ianrrees/scoreboard-hardware/README.md

# scoreboard-hardware
PCB design files for an I2C controlled LED 7-segment digit.

## TODO

  * Explain the idea behind the top panel
  * Make sure the through hole LED silkscreen is visible after parts are placed
