ianrrees/scoreboard-hardware/scoreboard.pdf

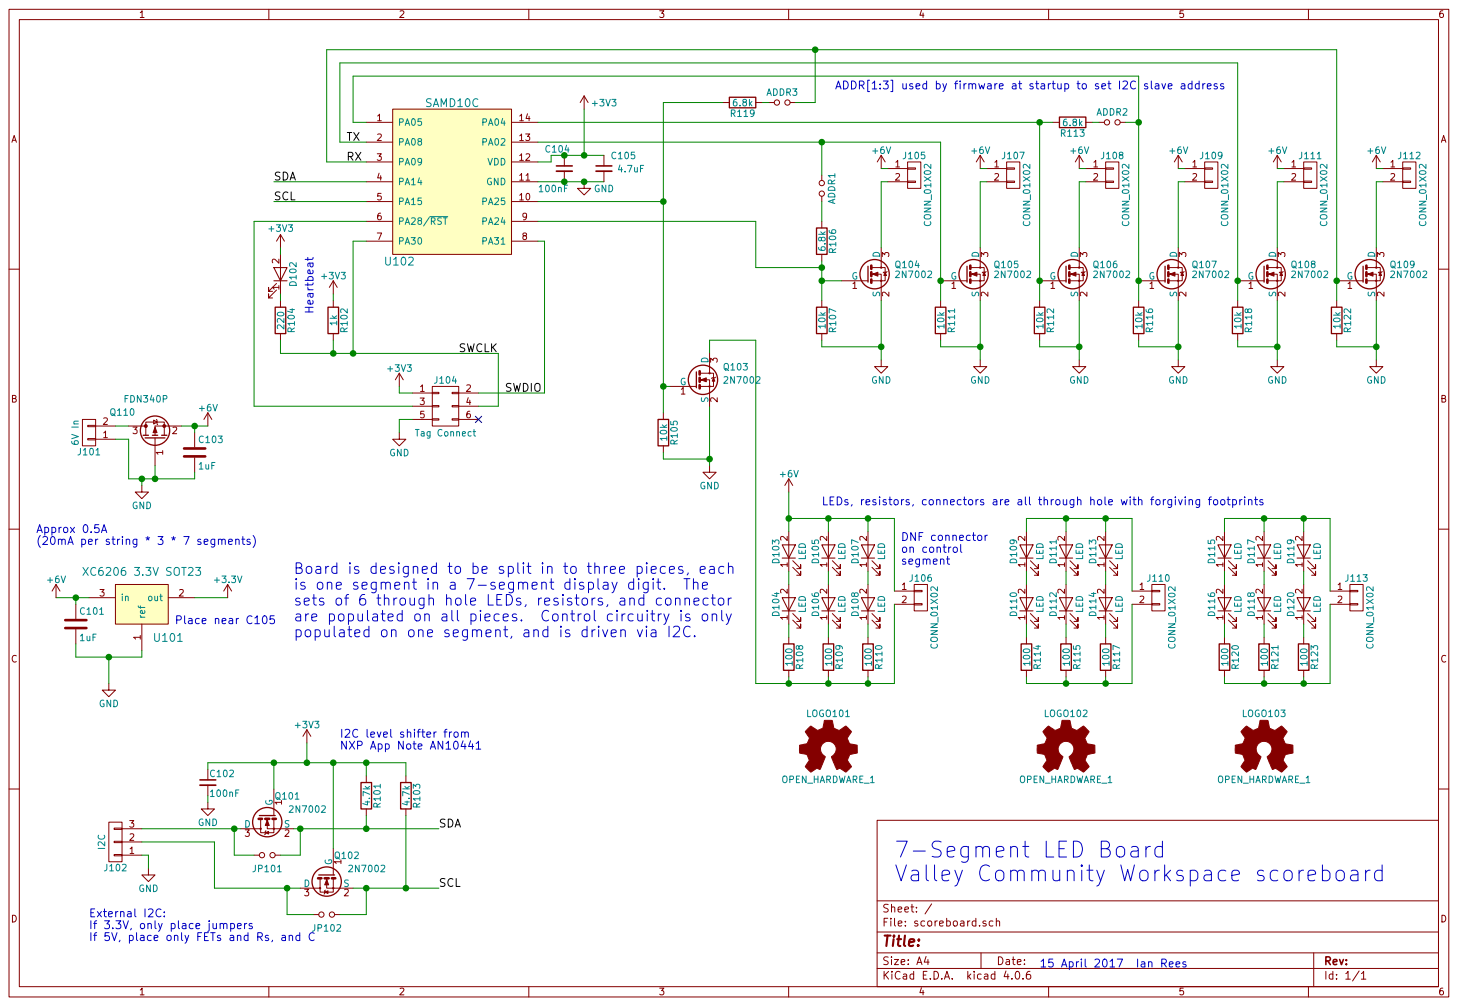
[picture p1: page 1]

sets of 6 through hole LEDs, resistors, and connector
are populated on all pieces. Control circuitry is only

Valley Community Workspace scoreboard

Id: 1/1 Title: File: scoreboard.sch Sheet: /

If 3.3V, only place jumpers
If 5V, place only FETs and Rs, and C
