ianrrees/scoreboard-hardware/scoreboard.kicad_pcb

## KiCad design scoreboard.kicad_pcb (2017-05-03)

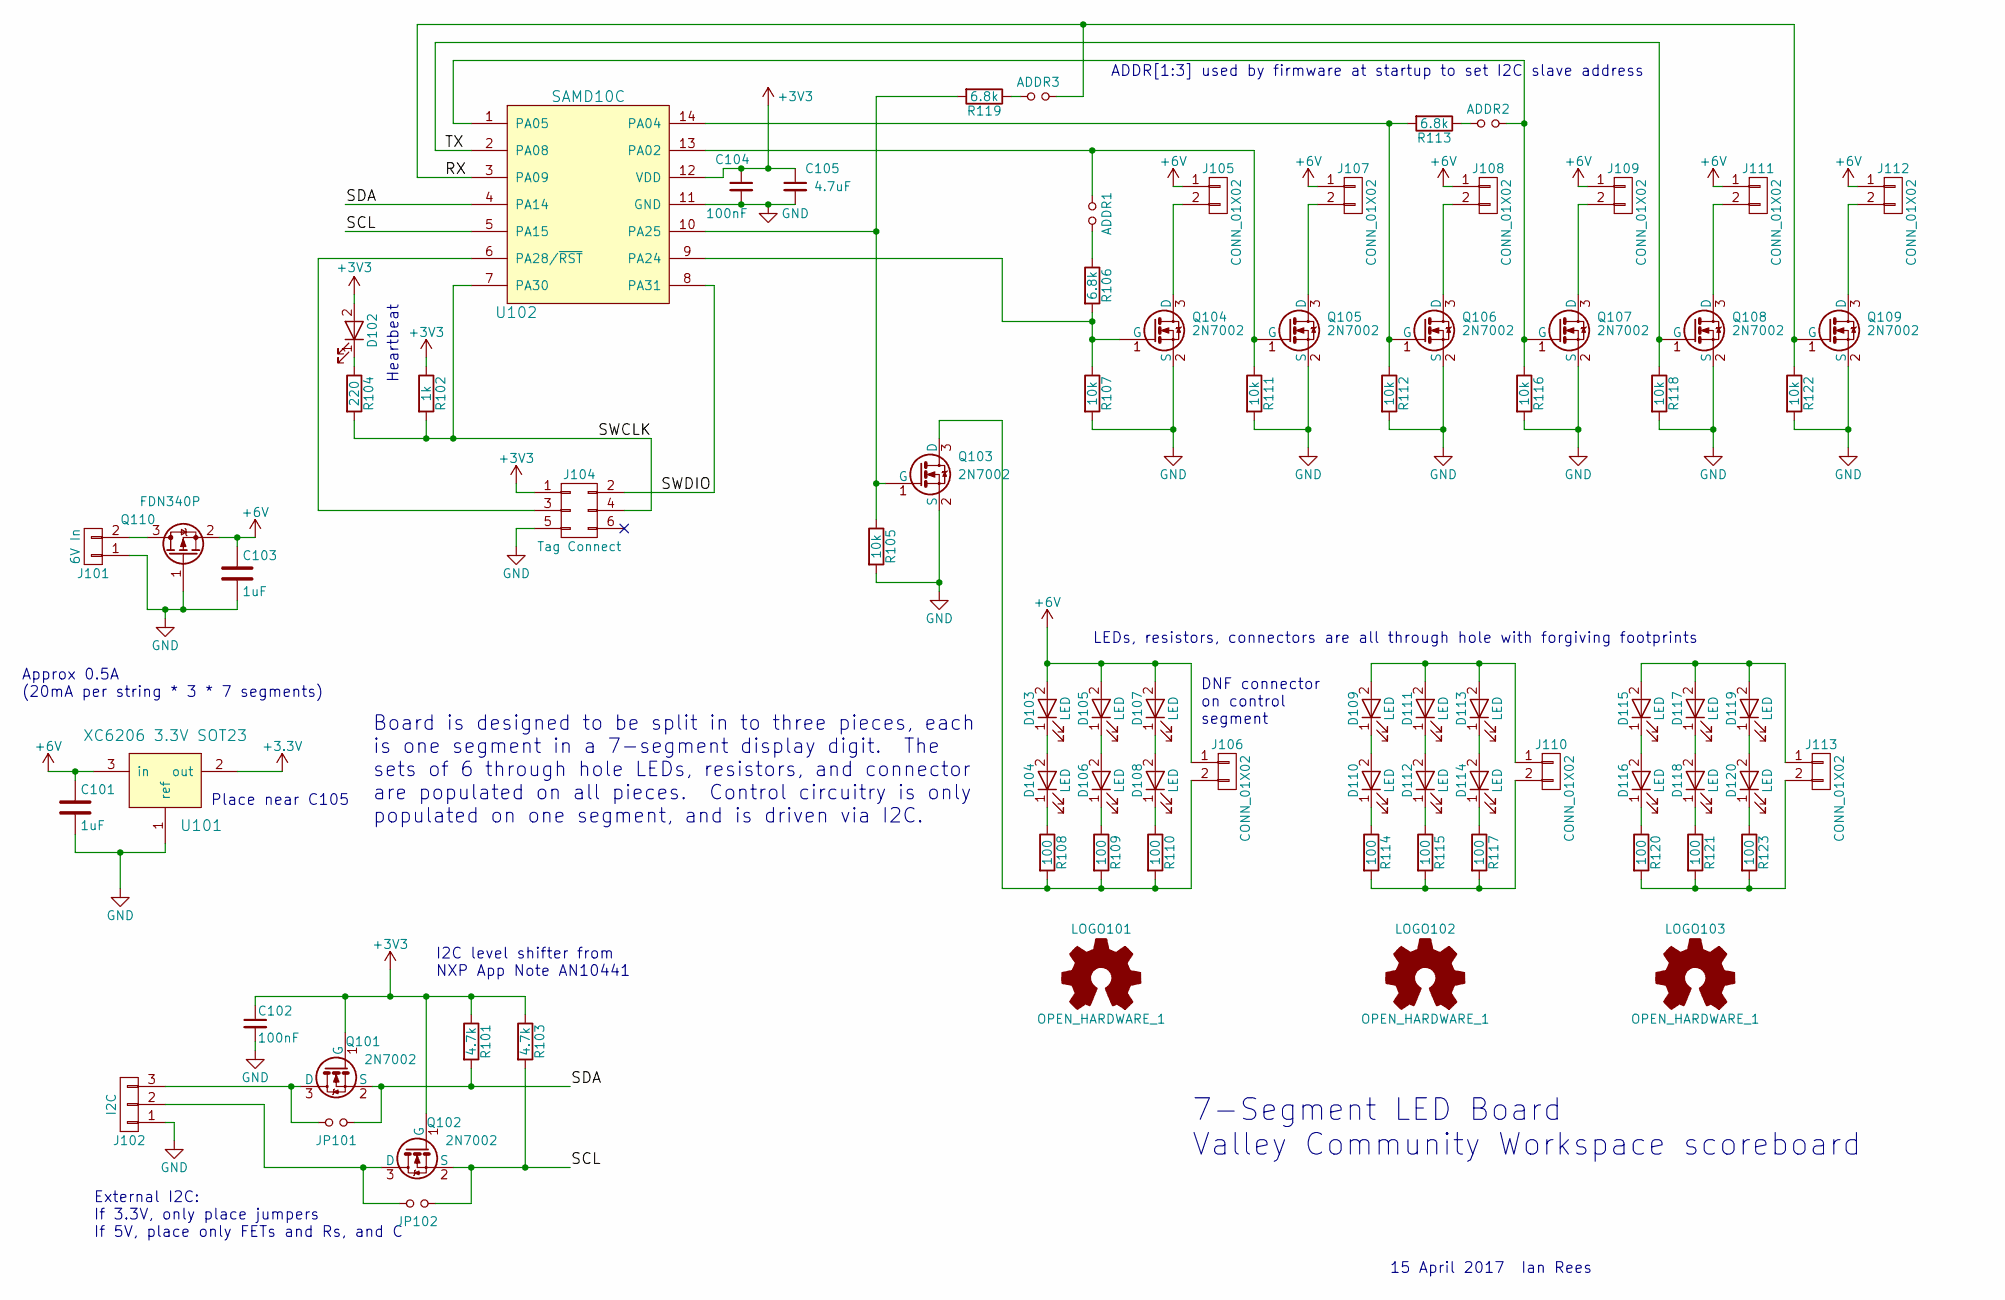
[picture p2: schematic scoreboard.sch]

Parts:
ADDR1, ADDR2, ADDR3: Jumper_NO_Small; solder_jumper
C101, C103: 1uF; C_0603_HandSoldering
C102, C104: 100nF; C_0603_HandSoldering
C105: 4.7uF; C_0603_HandSoldering
D102: LED; led_0603_HandSoldering
D103, D104, D105, D106, D107, D108, D109, D110, D111, D112, D113, D114, D115, D116, D117, D118, D119, D120: LED; LED_D5.0mm
J101: 6V In; AK300-min
J102: I2C; Molex_MicroLatch-53253-0370_03x2.00mm_Straight
J104: Tag Connect; Tag-Connect_TC2030-IDC-FP
J105, J106, J107, J108, J109, J110, J111, J112, J113: CONN_01X02; AK300-min
JP101, JP102: Jumper_NO_Small; R_0603_HandSoldering
LOGO101, LOGO102, LOGO103: OPEN_HARDWARE_1; Symbol_OSHW-Logo_CopperTop
Q101, Q102, Q103, Q104, Q105, Q106, Q107, Q108, Q109: 2N7002; SOT-23
Q110: FDN340P; SOT-23_Handsoldering
R101, R103: 4.7k; R_0603_HandSoldering
R102: 1k; R_0603_HandSoldering
R104: 220; R_0603_HandSoldering
R105, R107, R111, R112, R116, R118, R122: 10k; R_0603_HandSoldering
R106, R113, R119: 6.8k; R_0603_HandSoldering
R108, R109, R110, R114, R115, R117, R120, R121, R123: 100; R_Axial_DIN0411_L9.9mm_D3.6mm_P15.24mm_Horizontal
U101: XC6206 3.3V SOT23; SOT-23_Handsoldering
U102: SAMD10C; SOIC-14_3.9x8.7mm_Pitch1.27mm

Connections:
+6V: C101.1, C103.1, D103.2 (A), D105.2 (A), D107.2 (A), J105.1, J106.1, J107.1, J108.1, J109.1, J111.1, J112.1, Q110.2 (S), U101.3 (in)
/RX: ADDR3.2, Q109.1 (G), R122.1, U102.3 (PA09)
/SCL: JP102.2, Q102.2 (S), R103.2, U102.5 (PA15)
/SDA: JP101.2, Q101.2 (S), R101.2, U102.4 (PA14)
/SWCLK: J104.4, R102.2, R104.2, U102.7 (PA30)
/SWDIO: J104.2, U102.8 (PA31)
/TX: Q108.1 (G), R118.1, U102.2 (PA08)
GND: C101.2, C102.2, C103.2, C104.2, C105.2, J101.1, J102.1, J104.5, Q103.2 (S), Q104.2 (S), Q105.2 (S), Q106.2 (S), Q107.2 (S), Q108.2 (S), Q109.2 (S), Q110.1 (G), R105.2, R107.2, R111.2, R112.2, R116.2, R118.2, R122.2, U101.1 (ref), U102.11 (GND)
unnamed: ADDR1.1, Q105.1 (G), R111.1, U102.13 (PA02)
unnamed: ADDR1.2, R106.1
unnamed: ADDR2.1, R113.1
unnamed: ADDR2.2, Q107.1 (G), R116.1, U102.1 (PA05)
unnamed: ADDR3.1, R119.1
unnamed: D102.1 (K), R104.1
unnamed: D103.1 (K), D104.2 (A)
unnamed: D104.1 (K), R108.1
unnamed: D105.1 (K), D106.2 (A)
unnamed: D106.1 (K), R109.1
unnamed: D107.1 (K), D108.2 (A)
unnamed: D108.1 (K), R110.1
unnamed: D109.1 (K), D110.2 (A)
unnamed: D109.2 (A), D111.2 (A), D113.2 (A), J110.1
unnamed: D110.1 (K), R114.1
unnamed: D111.1 (K), D112.2 (A)
unnamed: D112.1 (K), R115.1
unnamed: D113.1 (K), D114.2 (A)
unnamed: D114.1 (K), R117.1
unnamed: D115.1 (K), D116.2 (A)
unnamed: D115.2 (A), D117.2 (A), D119.2 (A), J113.1
unnamed: D116.1 (K), R120.1
unnamed: D117.1 (K), D118.2 (A)
unnamed: D118.1 (K), R121.1
unnamed: D119.1 (K), D120.2 (A)
unnamed: D120.1 (K), R123.1
unnamed: J101.2, Q110.3 (D)
unnamed: J102.2, JP102.1, Q102.3 (D)
unnamed: J102.3, JP101.1, Q101.3 (D)
unnamed: J104.3, U102.6 (PA28/~RST)
unnamed: J105.2, Q104.3 (D)
unnamed: J106.2, Q103.3 (D), R108.2, R109.2, R110.2
unnamed: J107.2, Q105.3 (D)
unnamed: J108.2, Q106.3 (D)
unnamed: J109.2, Q107.3 (D)
unnamed: J110.2, R114.2, R115.2, R117.2
unnamed: J111.2, Q108.3 (D)
unnamed: J112.2, Q109.3 (D)
unnamed: J113.2, R120.2, R121.2, R123.2
unnamed: Q103.1 (G), R105.1, R119.2, U102.10 (PA25)
unnamed: Q104.1 (G), R106.2, R107.1, U102.9 (PA24)
unnamed: Q106.1 (G), R112.1, R113.2, U102.14 (PA04)

Notes on the sheet:
External I2C: If 3.3V, only place jumpers If 5V, place only FETs and Rs, and C
I2C level shifter from NXP App Note AN10441
Heartbeat
LEDs, resistors, connectors are all through hole with forgiving footprints
Board is designed to be split in to three pieces, each is one segment in a 7-segment display digit. The sets of 6 through hole LEDs, resistors, and connector are populated on all pieces. Control circuitry is only populated on one segment, and is driven via I2C.
DNF connector on control segment
ADDR[1:3] used by firmware at startup to set I2C slave address
7-Segment LED Board Valley Community Workspace scoreboard
15 April 2017 Ian Rees
Place near C105
Approx 0.5A (20mA per string * 3 * 7 segments)

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
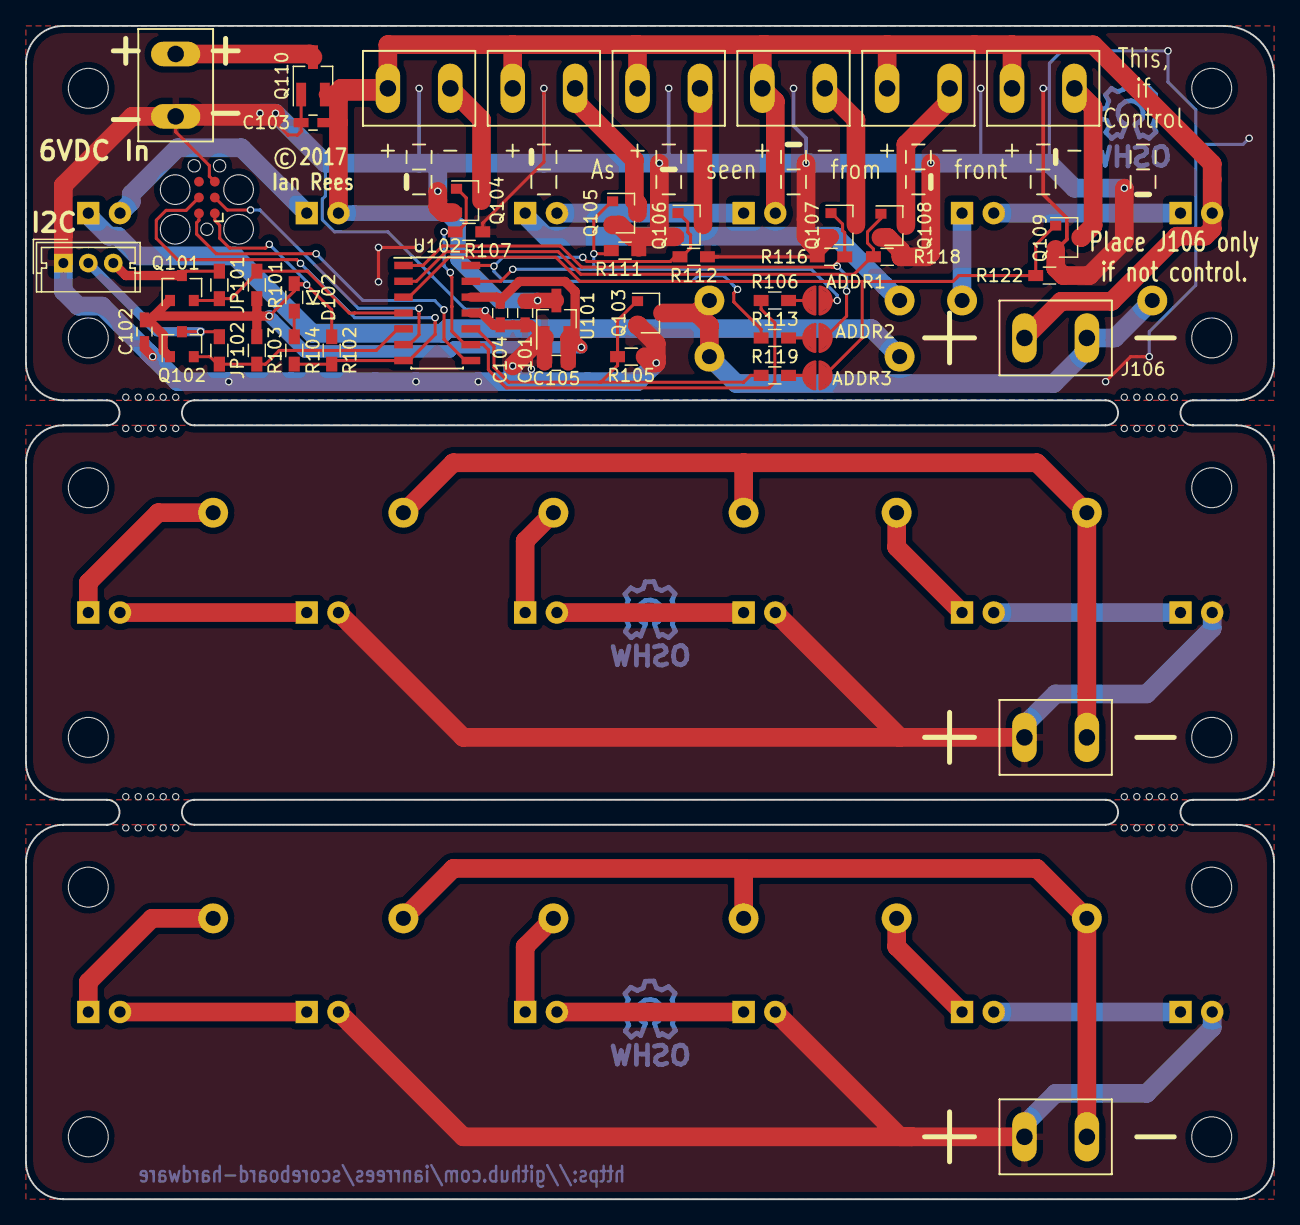
[picture p3: board scoreboard.kicad_pcb from above]

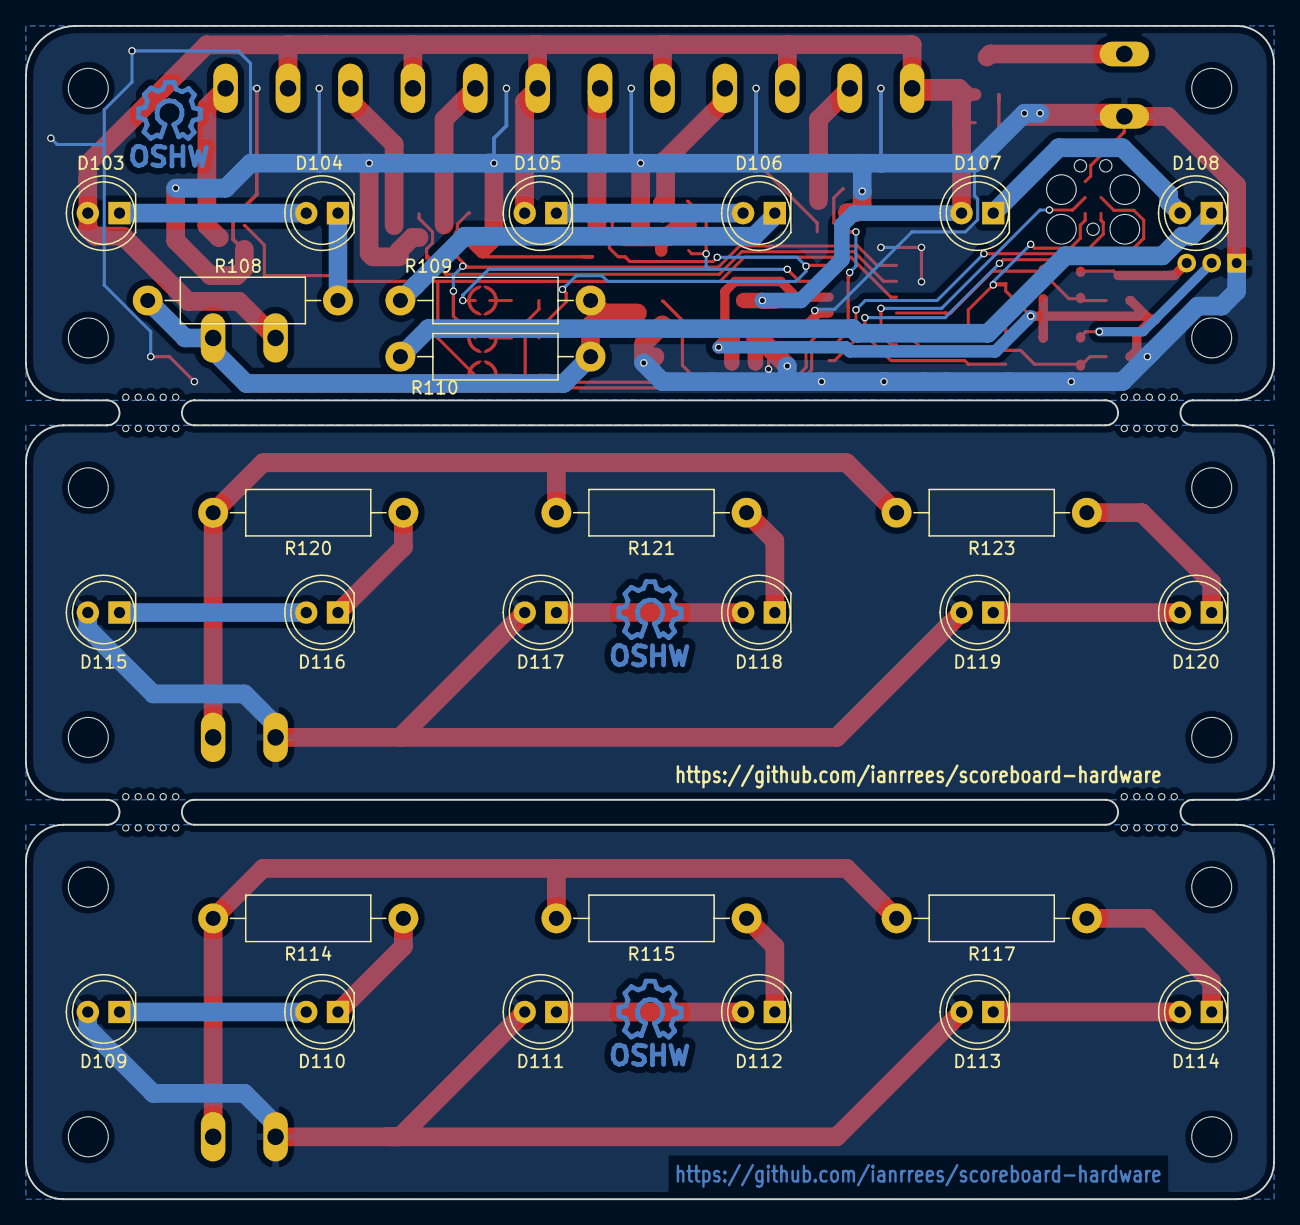
[picture p4: board scoreboard.kicad_pcb from below]

Board: 2 copper layers, 100.0 x 94.0 mm, 79 parts (30 on the bottom side), 51 nets.
