ianrrees/scoreboard-hardware/(commit log)

2017-04-15 First cut at a schematic
    [scoreboard.kicad_pcb, scoreboard.sch]
2017-04-29 Prepare for first order
    [scoreboard.kicad_pcb, scoreboard.sch]
2017-05-03 PCB updated and gerbers added as ordered
    [scoreboard.kicad_pcb, scoreboard.sch]
